orhuntas/EE464HW-SontAS/README.md

# EE464HW-SontAS
EE464 Hardware Project Repository for Şönt A.Ş.
