orhuntas/EE464HW-SontAS/simulation report/title.tex

\begin{titlepage}
\newcommand{\HRule}{\rule{\linewidth}{0.5mm}}
\setlength{\topmargin}{0 in}
\begin{center}

\begin{figure}[!h]
\centering
\includegraphics [width=0.3\textwidth]{eelogo.png}
\end{figure}

\vspace{10mm}
\Huge{MIDDLE EAST TECHNICAL UNIVERSITY}\\
\vspace{5mm}
{\LARGE ELECTRICAL \& ELECTRONICS ENGINEERING}\\
\vspace{4mm}
\LARGE{Şönt A.Ş.}\\

\HRule\\[0.4cm]
\textsc{\Large{EE464 - STATIC POWER CONVERSION II}}\\
\textsc{\Large{Hardware Project - Flyback Converter\\}}
\textsc{\Large{Simulation Report\\}}
\HRule\\[0.4cm]

\vspace{3mm}

\end{center}
\begin{minipage}{1\textwidth}
		\begin{flushleft}
			\large
			Orhun  \textsc{Taşoğlu - 2094506}\\
			Fahri \textsc{Türedi - 2167435}\\
			Nurettin \textsc{Çavuş - 2094878}
			
		\end{flushleft}
	\end{minipage}

\vspace{10mm}
\begin{center}
\large{23.03.2020}
\end{center}
\end{titlepage}
