orhuntas/EE464HW-SontAS/Final Report/tex/main.tex

\documentclass[12]{article}

\usepackage{gensymb}

\usepackage{float}
\usepackage{float}
\usepackage{booktabs}
\usepackage{multirow}
\usepackage{subcaption}

\usepackage{amsmath}

\usepackage[utf8]{inputenc}
\usepackage[T1]{fontenc}
\setlength{\oddsidemargin}{0.25 in}
\setlength{\evensidemargin}{-0.25 in}
\setlength{\topmargin}{-0.6 in}
\setlength{\textwidth}{6.5 in}
\setlength{\textheight}{8.5 in}
\setlength{\headsep}{0.75 in}
\setlength{\parindent}{0 in}
\setlength{\parskip}{0.1 in}
\usepackage[a4paper,margin=3 cm,footskip=.5cm]{geometry}
\usepackage{textcomp}
\usepackage[table,xcdraw]{xcolor}
\usepackage{hyperref}

\hypersetup{
    colorlinks,
    citecolor=black,
    filecolor=black,
    linkcolor=blue,
    urlcolor=blue
}
\usepackage{graphicx}
\usepackage[inkscapeformat=pdf,inkscapelatex=false]{svg}
%https://www.overleaf.com/project/5ecb94c99100ce000119a4ac
\graphicspath{ {./figs/} }

\begin{document}

\input{title.tex}
\tableofcontents
\newpage
\input{Introduction}
\input{Flyback_Design}
\input{Magnetic_Design}
\input{Simulations}
\input{Component_Selection}
\input{Efficiency_Analysis}
\input{Thermal_Analysis}
\input{Closed_Loop_Control}
\input{PCB_Design}
\input{Conclusion}
\input{Acknowledgement}
\input{References}
\end{document}
