orhuntas/EE464HW-SontAS/Final Report/tex/References.tex

\section{References}
 $[1]$ Hart, D. W. (2011). Power electronics. New York: McGraw-Hill\\
 $[2]$ Erickson, R. W. (2020). Fundamentals of Power Electronics. Boston: SPRINGER NATURE\\
 $[3]$ Hurley, W.G. , Wölfle, W.H. (2013). Transformers and Inductors for Power Electronics. Noida:John Wiley & Sons Ltd. \\
 $[4]$ UCC28740 datasheet. (n.d.). Retrieved June 24, 2020, from https://www.ti.com/document-viewer/UCC28740/datasheet/features-slusb417558\\
 $[5]$ Seri Lee. (2015) How to Select Heat Sink from https://www.mouser.com/catalog/specsheets/ AavidHowtoSelectaHeatSink.pdf\\
