orhuntas/EE464HW-SontAS/Final Report/PCB/pcbcomplete/flyback.html

# C:\Users\Fahri\Desktop\flyback\flyback.sch

02.06.2020 00:22:01

Eeschema (5.0.0)

Component Count:32

Ref | Qnty | Value | Part | Datasheet | Description | Vendor
CFB1, Ccs1, Cext1, Css431, Cvdd1, Cz1 | 6 | C | Device:C | ~ | Unpolarized capacitor
Cout1, Cout2 | 2 | CP1 | Device:CP1 | ~ | Polarised capacitor
D1 | 1 | D | Device:D | ~ | Diode
Daux1 | 1 | DIODE | pspice:DIODE
Dclamp1 | 1 | D_Zener | Device:D_Zener | ~ | Zener Diode
Dout1 | 1 | D_Schottky | Device:D_Schottky | ~ | Schottky diode
J1, J2 | 2 | Screw_Terminal_01x02 | Connector:Screw_Terminal_01x02 | ~ | Generic screw terminal, single row, 01x02, script generated (kicad-library-utils/schlib/autogen/connector/)
Lout1 | 1 | L | Device:L | ~ | Inductor
M1 | 1 | MNMOS | pspice:MNMOS | | N-channel MOSFET
R9, RFB1, RFB2, RFB3, RFB4, RLC1, RTL1, RVS1, RVS2, RinJ1 | 10 | R | Device:R | ~ | Resistor
RCS1, Rvdd1 | 2 | R | Device:R | ~ | Resistor
T1 | 1 | Transformer_1P_2S | Device:Transformer_1P_2S | ~ | Transformer, single primary, dual secondary
TL431 | 1 | TL431D | Reference_Voltage:TL431D | http://www.ti.com/lit/ds/symlink/tl431.pdf | Shunt Regulator, SO-8
U1 | 1 | SFH617A-1 | Isolator:SFH617A-1 | http://www.vishay.com/docs/83740/sfh617a.pdf | Optocoupler, Phototransistor Output, 5300 VRMS, VCEO 70V, CTR% 40-80, -55 to +110 degree Celcius, UL, BSI, FIMKO, cUL, THT PDIP-4
U2 | 1 | NCP1207B | Regulator_Controller:NCP1207B | http://www.onsemi.com/pub/Collateral/NCP1207B.PDF | PWM Current-Mode Controller for Free Running Quasi-Resonant Operation, AC-DC, 4.5us min Toff, SOIC-7
