orhuntas/EE464HW-SontAS/EE464_Hardware_Project.pdf

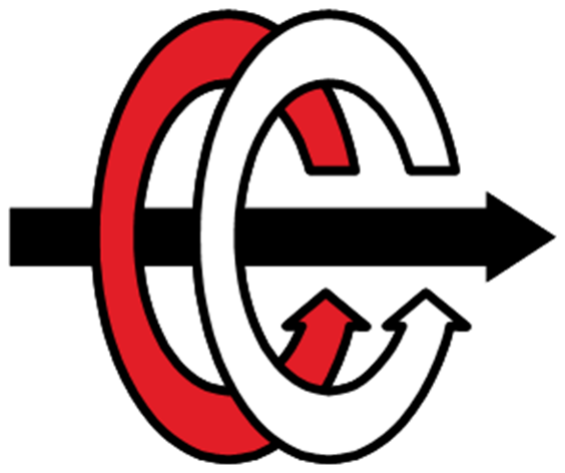
[picture p92: figure]

# MIDDLE EAST TECHNICAL UNIVERSITY

## ELECTRICAL & ELECTRONICS ENGINEERING

Şönt A.Ş.

EE464 - STATIC POWER CONVERSION II

Hardware Project - Flyback Converter

Simulation Report

Orhun Taşoğlu - 2094506

Fahri Türedi - 2167435
Nurettin Çavuş - 2094878

23.03.2020

## Contents

1 Introduction | 2
2 Topology Selection | 2
3 Flyback Converter Design | 4
4 Simulation Results | 8
5 Component Selection | 22
6 Conclusion | 28
7 References | 28

## 1 Introduction

One of the most commonly used circuit to perform DC-DC conversions are Switching Mode Power Supplies (SMPS). To provide a safer output and to comply with international standards isolation of output from the input side is required, especially in grid-connected applications. There are two main topologies of the dc-dc converters with galvanic isolation which means there is no electrical contact between two sides are the Flyback Converters and Forward Converters. These topologies provide isolation thanks to the isolation transformer placed between the two sides. The isolation transformer also provides larger bandwidth or operation range on the voltage transfer capabilities by adjusting the primary to secondary turns ratio. Hence, these topologies reduce the weight of the duty ratio on the voltage transfer capability by having the turn ratio of the transformer to make the most of the work.

In this report, fundamental points of our design, parameter calculations. simulation results and key components for building the Flyback Converter topology are explained. First of all, the reasoning behind the topology selection is presented. Then, the design methodology of the Flyback Converter is given with the design goals and parameter calculations in the following part. The magnetic design of the transformer is also be explained in detail. Depending on the design selections and computed parameters, the simulation results of the constructed topology is presented in the Simulation Results part of the report. Finally, the component selections for the semiconductor devices are included according to the maximum current and voltage stresses over them, which are computed by the analytical calculations and observed during the simulations. The magnetic core selection for the transformer is can be found in that part of the report too. Furthermore, the appropriate cable selection both for the primary and secondary sides of the transformer is done considering the effects like the skin effect and the proximity effect together with the maximum currents flowing through the transformer windings.

## 2 Topology Selection

Selected Topology: FLY#1

We, as Şönt A.Ş., selected the Flyback Converter topology FLY#1 over Flyback Converter options and Forward Converter topology for a number of reasons. First of all, it includes less number of components compared to the Forward Converter topology. Hence, the cost is reduced compared to the Forward Converter topology. Another reason is that it does not require an output filter inductor, which makes the magnetic design phase easier compared to the Forward Converter topology. As a result, there is no need for a second core selection and extra magnetic design for an output filter inductor. In terms of these aspects, the Flyback Converter topology is the simplest topology among the other options.

Furthermore, the voltage gain control of the Flyback Converter topology in DCM operation is easier than that in the Forward Converter topology. As a result, the current mode control and the voltage mode control of the Flyback Converters can be made in DCM operation, which also helps to reduce the current stress over the MOSFET and the diode during switching since the switching is done when the current is equal to zero. Zero current switching also eliminates the reverse recovery losses over the output rectifier diode. Furthermore, the DCM operation allows switching the MOSFET when the voltage across the drain to source terminals of the MOSFET is approximately equal to the input voltage. This greatly reduces the switching losses of the converter since the switching losses are proportional to the square of the drain to source voltage of the MOSFET.

The availability of DCM operation also enables the valley switching operation, which further decreases the switching losses by making it possible to switch the MOSFET while the drain to source voltage is at its minimum below the input voltage. This operation requires frequency modulation (FM) controlled by a controller. Since we found the UCC28740 to be widely available, inexpensive and capable of completing the tasks given in the project, we decided to build our Flyback Converter around it. The EMI effects are also reduced with the valley switching operation. All in all, these operation modes make the Flyback Converter topology obtain a higher efficiency than Forward Converter topology. One another advantage of the availability of DCM operation is that it helps to reduce the required inductance value for the transformer, which helps to reduce the transformer size and weight. If we evaluate the two topologies in terms of voltage stress over the switching MOSFET, the voltage stress over the switching MOSFET in Flyback Converter topology is less than that in the Forward Converter topology. These points and considerations conclude our selection of Flyback Converter topology over Forward Converter topology.

Now, the final topology selection among the three possible Flyback Converter topology options FLY#1, FLY#2 and FLY#3 will be explained.

If we compare the Flyback Converter topology options FLY#1, FLY#2 and FLY#3 in itself, we did not want to work with AC input voltage since it would require an extra input full bridge rectifier together with an very large filter capacitor at the rectifier output. This eliminated the option FLY#3 for us. Then, between FLY#1 and FLY#2, we selected the FLY#1 option since its output voltage is higher than that of FLY#2 option. This makes the average output current in FLY#1 less than that in the FLY#2, which helps to increase the efficiency in the FLY#1 option compared to FLY#2 option. Also, the current ripples and maximum current ratings will be smaller in FLY#1 due to smaller average output current. In addition, the higher output voltage for the same output voltage ripple limit of 4% helps to choose the output filter capacitor smaller in FLY#1 option, which reduces the filter size. For these reasons, we selected the FLY#1 option.

## 3 Flyback Converter Design

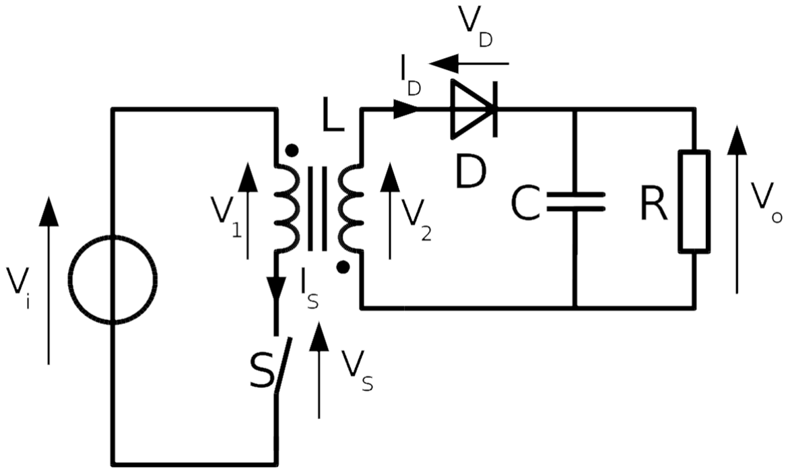
[picture p93: figure]

Figure 1: Ideal Flyback Converter

An ideal flyback converter topology is given in Figure 1. It is a galvanically isolated DC-DC converter with a special feature. That special feature is using the magnetizing inductance of the transformer as an energy storage device, instead of a separate circuit component, which helps reduce the cost, volume and mass of the converter. For our hardware project, we will build a Flyback Converter with extra features to establish the flexibility and performance required to achieve the main requirements and collect bonus points from the Hardware Project.

Our circuit’s main controller is UCC28740 by Texas Instruments. It can achieve both current mode and voltage mode control by taking feedback from input and output sides. For UCC28740 to perform properly, the rest of the circuit should be set to achieve DCM operation at all times. UCC28740 can achieve valley switching, which means it will try to switch the MOSFET at the lowest possible voltage than the primary voltage to increase the efficiency. Those voltage levels are called valley points which are bottoms of the voltage swing at the primary, as seen in Figure 2. The lower voltage level is seen because of the ringing when primary current reaches zero. This kind of Flyback Converter called Quasi-Resonant Flyback Converter.

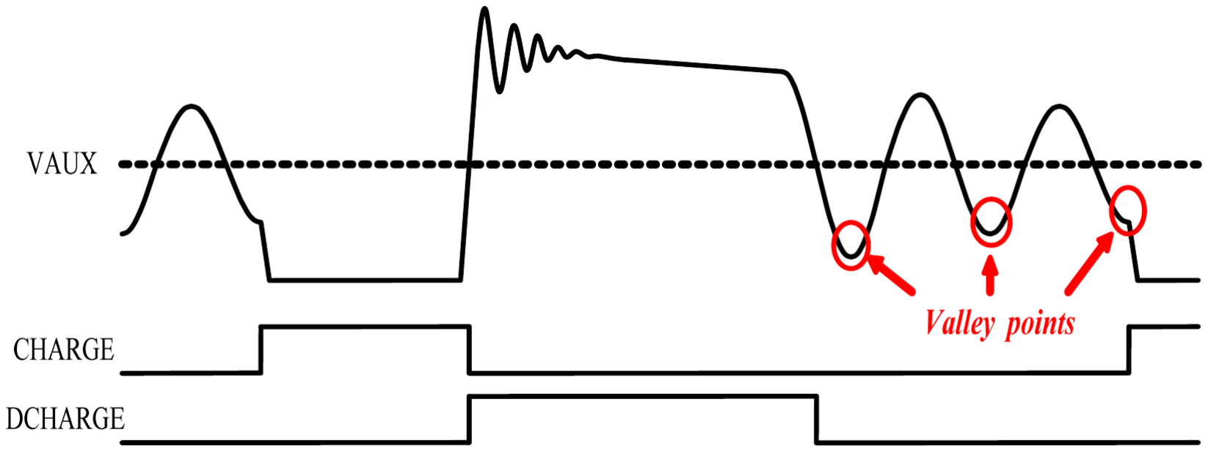
[picture p94: figure]

Figure 2: Vallet Points of a Quasi-Resonant Flyback Converter

To be able to handle synchronous switching, UCC24636 by Texas Instruments will be used at the secondary side. The reference design for the mentioned ICs is given in Figure 3.

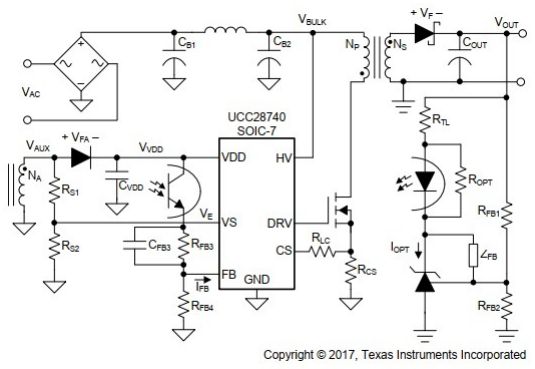
[picture p95: figure]

Figure 3: Reference Flyback Converter Design with UCC28740

### 3.1 Design Goals

Complying with the specifications given in the project description, Table 1 is prepared as a summary. Our design must accomplish the given performance measures. In addition to these, the circuit must employ a closed-loop control. Furthermore, to maximize the functionality and gain bonus points we aimed to go for each positive bonus parts described.

Table 1: Project Specifications
Paremeter | Min | Typical | Max | Unit
INPUT
Vin | Input Voltage | 24 | 36 | 48 | VDC
OUTPUT
Vout | Output Voltage | 14.4 | 15 | 15.6 | VDC
Iout | Output Current | - | 3.75 | - | A
Pout | Output Power | | 60 | | W
| Line Regulation | | | 2 | %
Load Regulation | 2 | % height

### 3.2 Parameter Calculations

Duty Cycle, Turns Ratio, Primary Inductance, Peak Primary Current

Since the target maximum switching frequency imposed by the limitations of our controllers, it is designated as 45 kHz. DMAGCC is defined as ‘The secondary diode conduction duty-cycle limit in CC mode, 0.425. which is a device parameter to make sure the transformer is demagnetized and DCM is established. Assuming 500 kHz as the DCM resonance frequency, the times it takes to reach the first valley of VDS, tR should be substracted so that valley switching can be made possible too. To find the maximum duty cycle for constant CCM operation,

DMAX = 1 − DMAGCC − fMAX ×

tR
2

DMAX = 1 − 0.425 − 45kHz ×

2µs
2

= 0.53

Since DMAX is known, maximum primary to secondary turns ratio can be determined with the following equation:

NP S,MAX =

DMAXVDC,min

DMAGCC (VO + vF

) = 0.53 × 24 0.425 ∗ (15.7) = 1.906

Since the voltage at the current sense feedback pin of the controller, VC ST is limited, first we need to determine de RCS to limit the the primary peak current,IP P .

RCS =

VCCRNP S
2IO

√
ηtransformer = 74.3mΩ

IP P,MAX =

VCST ,MAX

RCS

=

0.773
0.0746

= 10.4A

Where VCCR is a device parameter called constant-current regulation factor and is equal to 330mV. To compansate the voltage ripples on the input capactiors, a factor of 0.6 is used.

To ensure enough energy can be stored in the transformer and DCM operation is established, primary inductance should be specified properly It should be noted that the transformer will cause losses so they need to taken into consideration too. Assuming % efficiency, magnetizing inductance is calculated.

LP =

2(VO + VF )IO

ηtransformerI

2
P P,MAXfMAX

=

2 × 15.7 × 4
0.9 × 10.4

2 × fMAX

= 28.67µH

Lastly, since we will need an auxiliary winding to power the controller to sense the primary voltage and utilize low voltage lockout, turns ratio of it should be calculated too. Assuming the lockout voltage to be 15V, and auxiliary diode voltage drop to be 0.5 Volts. Lastly, the upper limit for auxiliary to secondary turns ratio is calculated according to the lowest supply voltage of the controller, VDD,of f

NAS,MAX =

VDD,min + VF A
VO + VF

=

7.75 + 0.5
15 + 0.7

= 0.525

NP A,MAX =

1.9
0.525

= 3.62

### 3.3 Transformer Parameter Verification

To be able to choose our components properly, the stresses on them should be calculated to make an informed decision. Turns ratio of the transformer affects the peak voltages on the rectifiers. Also, demagnetization and MOSFET on times are should be verified so that the values are in the internal timing limits of our controller. Reverse voltages on primary and secondary rectifiers are,

VReverse,secondary =

VIN,MAX√
2
NP S

+ VO,MAX = 77.8V

VReverse,primary =

VIN,MAX
NP A

+ VV DD = 23.25V

For MOSFET VDS peak voltage calculation;

VDS,peak = VIN,MAX + (VO + VF )NP S = 97V

To find our circuits ON time and Demagnetization times,

tON,min =

LP

VIN,MAX

Iprimary,MAX
4

= 1.51µs

tDmag.M in =

tON,minVIN,MAX
NP S(VO + VF )

= 2.9µs

The minimum required ON time for our controllers is indicated as 280 nS and minimum Demagnetizing time is specified as 2.4 µS. Both criteria are satisfied and our circuit can operate in nominal conditions.

### 3.4 Magnetic Design

Firstly, the shape of the transformer core is selected as an E-core. Since E-cores can be winded better than toroid cores. To have enough turn numbers on both primary and secondary side, KOOL MU 2510 E CORE(00K2510E090) is selected. Cross-section area of the core is important for turn numbers and core area of the KOOL MU 2510 E CORE is small enough to have 10 turns on the primary side. Parameters of the chosen E-core is given below;

Ae = 35mm²
(CrossSectionArea) | (1)
le = 48.5mm(P athLength) | (2)
µc = 90(RelativeP ermeability) | (3)
Bc = 1T(SaturationFluxDensity) | (4)
W eight = 5.9gandVe = 1870mm³
(V olume) | (5)

According to chosen core secondary turn numbers was calculated.

NS =

LP × Ipeak
n × Bm × Ae

(6)

NS =

28.67 × 10⁻⁶ × 10.8
1.9 × 1 × 35 × 10⁻⁶
= 5.2turns | (7)

Ratio of the primary turn numbers to secondary turn numbers is calculated, so primary turn number is given below;

NP = n × NS = 1.9 × 5.2 = 10turns | (8)

In this flyback converter design, UCC28740 analog controller is chosen to control the output voltage and current. To supply VCC(7.75V) to UCC28740 analog controller, there is required auxiliary winding come from the transformer. The turn number of the auxiliary winding is calculated below;

NV CC =

VCC
VO + VF

× NS =

7.75
12 + 0.7
× NS = 3turns | (9)

There is a core gap on the E-core. Core gap is crucial because magnetic flux intensity can be controlled by the core gap. If there is smaller gap than required, the core can be saturated and transformer could not work properly. Also the other components of the flyback converter can be damaged due to overload. Required core gap is calculated to have optimum magnetic design. Calculation of the core gap is given below;

gap =

µ0 × NP

2 × Ae
LP

−

Ie
µc

=

1.256 × 10⁻⁶ × 10² × 35 × 10⁻⁶ 28.67 × 10⁻⁶

−

48.5 × 10⁻³
90

= 1.35 × 10⁻³m (10)

To check the calculated values given equations is done. Magnetic flux intensity is crucial, since if it is higher than the saturation level of the core, saturation level of the chosen core is 1 Tesla.

B =

µ0 × NP × IP

Ie
µc

+ gap

=

1.256 × 10⁻⁶ × 10 × 10.8

48.5×10⁻³
90 | + 3.85 × 10⁻³
= 0.95 | (11)

Vr =

NP
NS
× (VO + VF ) = 24.13V | (12)

0.95 Tesla is lower than saturation level of the core so it is acceptable. Also duty ratio must be lower than
0.53. To check duty ratio of the design, D is calculated below;

D =

Vr
Vr + V dc(min)
= 0.5 | (13)

## 4 Simulation Results

The designed converter topology is simulated in Simulink to verify desired functioning of the circuit.

For simplicity, the controller topology and feedback mechanisms are not included in the circuit schematic of the simulation model. Furthermore, the semiconductor devices and filter capacitors and inductors are taken ideal without voltage drops and ESR values.

In order to verify the operation of the circuit, we simulated the converter at its two extreme boundary points for input voltage of Vin = 24 V and Vin = 48 V .

The Simulink simulation model of the Flyback Converter circuit is given in Figure 4.

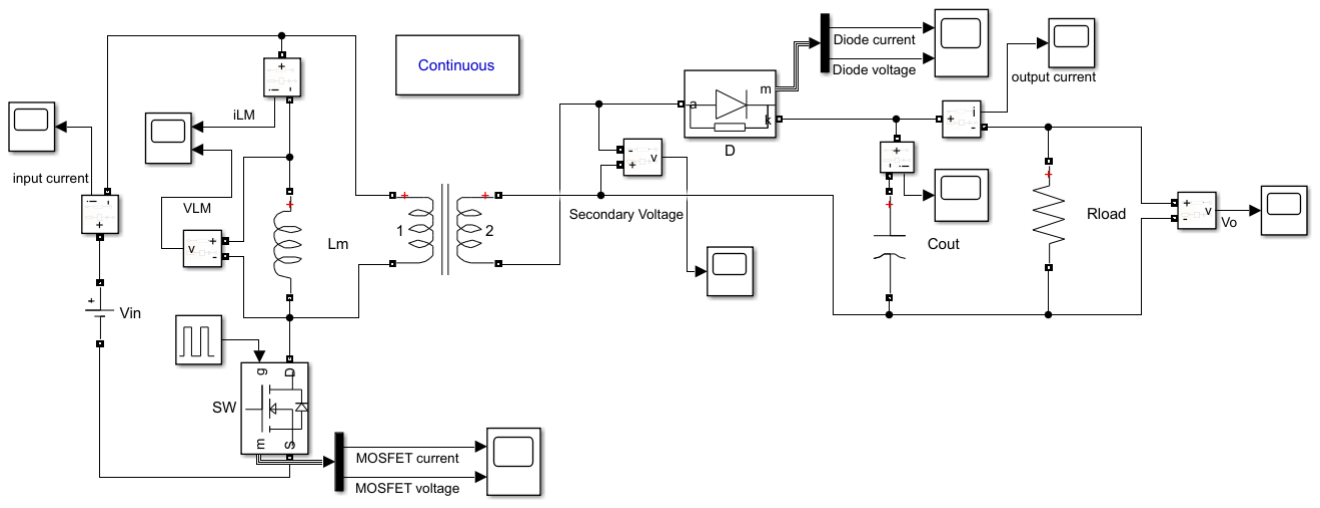
[picture p96: figure]

Figure 4: Simulink Circuit Schematic of the Flyback Converter

### 4.1 Simulation Results for Vin = 24 V

The simulation results of the converter circuit for input voltage of Vin = 24 V are given below.

The duty cycle of the MOSFET is determined as D = 52.5% (0.525) for this operation in order to keep the average output voltage at 15 V.

The duty cycle of the MOSFET is determined by some trial and errors since the converter circuit is operating in DCM. In DCM operation, the standard voltage gain equation can no more be utilized to determine the duty ratio.

The input current waveform of the converter circuit is given in Figure 5.

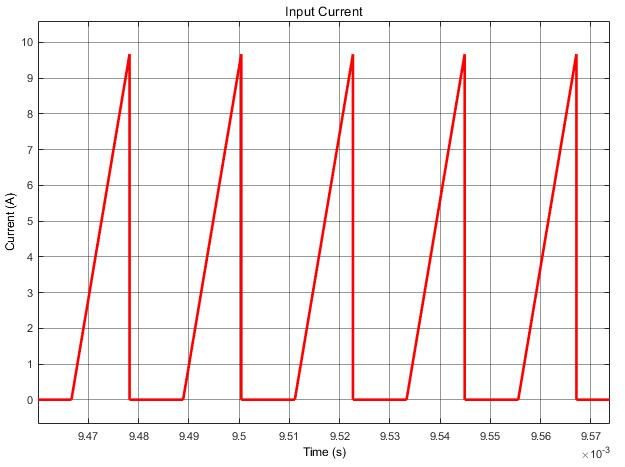
[picture p97: figure]

Figure 5: Input Current Waveform of the Flyback Converter for Vin = 24 V

The input current ripple is high as can be seen from Figure 5 since the switch is positioned in series to the input side. The maximum current drawn from the input source and the peak to peak input current ripple is equal to 9.681 A. The high input current ripple might cause EMI effects by affecting the operation of the analog controller and gate driver circuit of the switch.

The MOSFET current and voltage waveforms of the converter circuit are given in Figure 6.

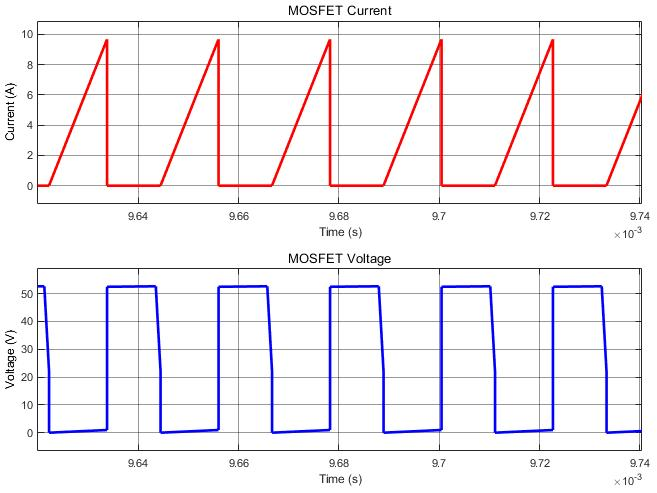
[picture p98: figure]

Figure 6: MOSFET Current and Voltage Waveforms of the Flyback Converter for Vin = 24 V

The maximum current through the MOSFET during its on period is observed from Figure 6 to be 9.681 A. The maximum voltage across the switch during its off period is also observed to be 52.63 V.

The voltage and current waveforms of the magnetizing inductor of the transformer of the converter circuit are given in Figure 7.

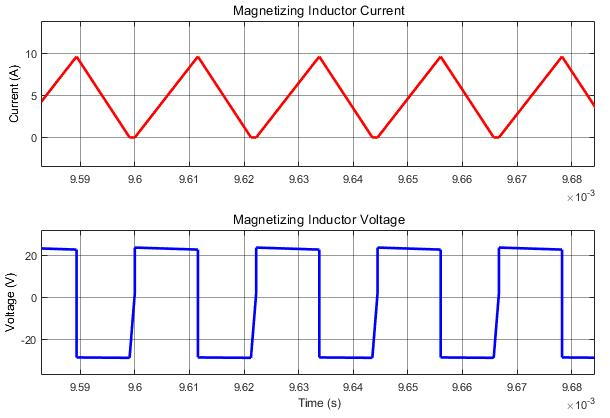
[picture p99: figure]

Figure 7: Magnetizing Inductor Voltage and Current Waveforms of the Flyback Converter for Vin = 24 V

The DCM operation of the converter circuit can also be observed from the magnetizing inductor current waveform given in Figure 7. It is seen from the Figure 7 that the inductor current reaches to zero and stays at zero for a finite duration until the next switching cycle.

The maximum magnetizing inductor current is observed to be equal to 9.669 A from the simulations.

The magnetizing inductor voltage switches between 24 V and -28.63 V during the switching operation.

The diode voltage and current waveforms of the converter circuit are given in Figure 8.

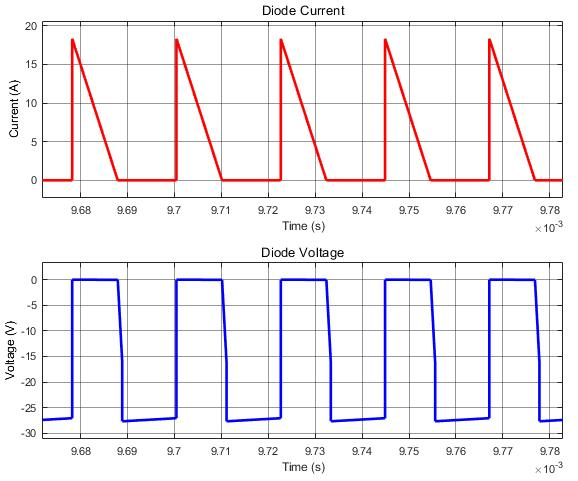
[picture p100: figure]

Figure 8: Diode Voltage and Current Waveforms of the Flyback Converter for Vin = 24 V

The voltage waveform on the secondary side of the transformer of the converter circuit is given in Figure ??.

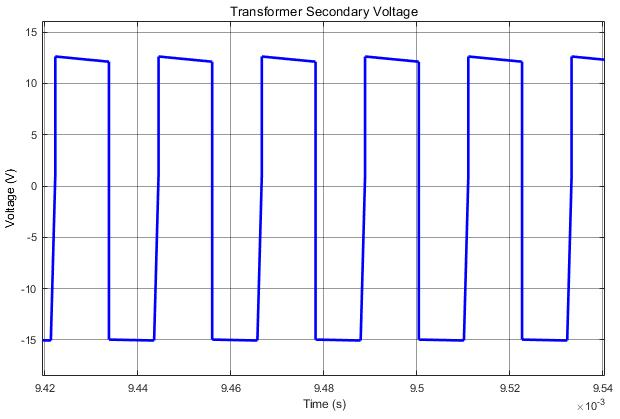
[picture p101: figure]

Figure 9: Secondary Voltage Waveform of the Transformer of the Flyback Converter for Vin = 24 V

The secondary side voltage of the transformer switches between 12.63 V and -15 V during the switching operation.

The output current waveform of the converter circuit is given in Figure 10.

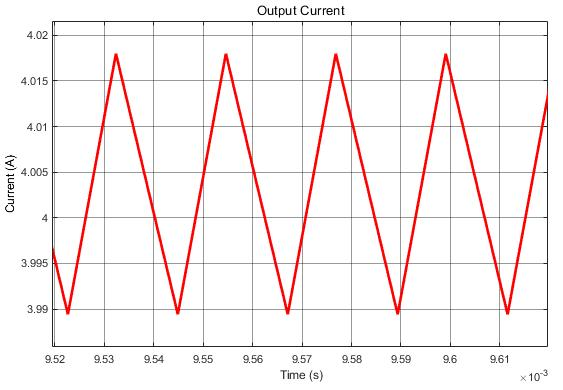
[picture p102: figure]

Figure 10: Output Current Waveform of the Flyback Converter for Vin = 24 V

The average output current is approximately obtained as 4 A.

The output voltage waveform of the converter circuit is given in Figure 11.

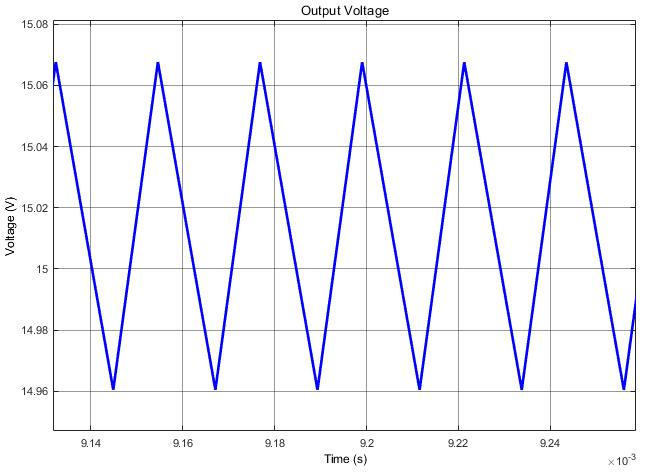
[picture p103: figure]

Figure 11: Output Voltage Waveform of the Flyback Converter for Vin = 24 V

The average output voltage is obtained as 15 V as can be seen from Figure 11. The peak to peak output voltage ripple is approximately equal to 0.116 V, which is less than the desired peak to peak output voltage ripple limit (4%) of 0.6 V.

### 4.2 Simulation Results for Vin = 48 V

The simulation results of the converter circuit for input voltage of Vin = 48 V are given below.

The duty cycle of the MOSFET is determined as D = 26% (0.26) for this operation in order to keep the average output voltage at 15 V.

As a result, the converter circuit is expected to be operated between 26% and 52.5% duty ratios between the two boundary input voltages of 24 V and 48 V.

The input current waveform of the converter circuit is given in Figure 12.

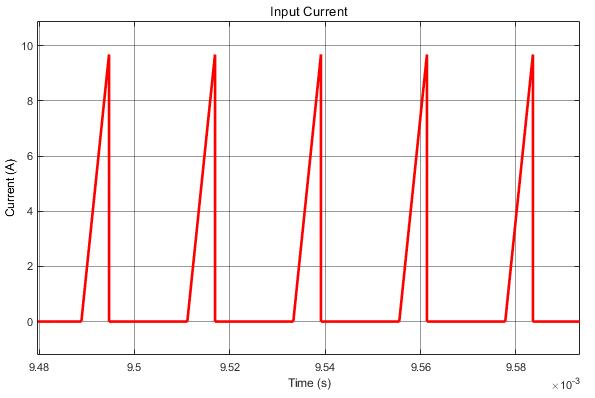
[picture p104: figure]

Figure 12: Input Current Waveform of the Flyback Converter for Vin = 48 V

Similar to the previous condition, the input current ripple is high as can be seen from Figure 12 since the switch is positioned in series to the input side. The maximum current drawn from the input source and the peak to peak input current ripple is equal to 9.690 A. The high input current ripple might cause EMI effects by affecting the operation of the analog controller and gate driver circuit of the switch.

The MOSFET current and voltage waveforms of the converter circuit are given in Figure 13.

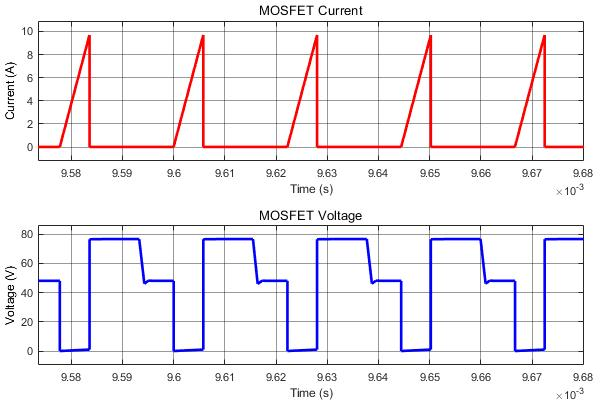
[picture p105: figure]

Figure 13: MOSFET Current and Voltage Waveforms of the Flyback Converter for Vin = 48 V

The maximum current through the MOSFET during its on period is observed from Figure 13 to be 9.690
A. The maximum voltage across the switch during its off period is also observed to be 76.63 V.

It is also possible to clearly observe the DCM operation of the converter circuit from the MOSFET voltage waveform given in Figure 13. During the off period of the switch, the voltage across the MOSFET is equal to 76.63 V until the magnetizing inductor current becomes zero. Then, until the next switching cycle (until the MOSFET becomes on again), the MOSFET voltage drops down to the input voltage (VMOSF ET = 48 V ) and stays at this level.

The voltage and current waveforms of the magnetizing inductor of the transformer of the converter circuit are given in Figure 14.

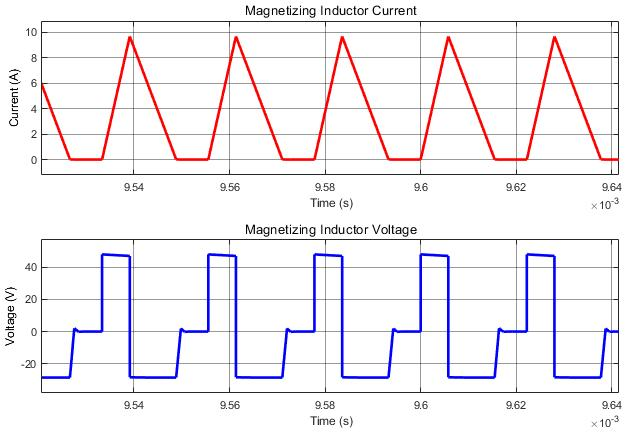
[picture p106: figure]

Figure 14: Magnetizing Inductor Voltage and Current Waveforms of the Flyback Converter for Vin = 48 V

Again, it is also possible to observe the DCM operation from the magnetizing inductor current and voltage waveforms given in Figure 14.

The maximum magnetizing inductor current for this operation is observed to be equal to 9.664 A.

The magnetizing inductor current discharges through the transformer and reaches to zero during the off period of the switch, and stays zero until the next switching cycle (until the MOSFET becomes on again). The magnetizing inductor voltage during that process changes from -28.63 V to 0 V when the inductor current becomes zero. During the on period of the switch, the magnetizing inductor voltage is equal to the input voltage (Vinductor = 48 V ), and the magnetizing inductor charges linearly.

The diode voltage and current waveforms of the converter circuit are given in Figure 15.

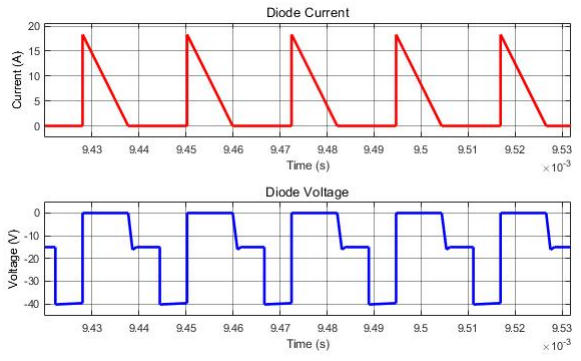
[picture p107: figure]

Figure 15: Diode Voltage and Current Waveforms of the Flyback Converter for Vin = 48 V

The DCM operation can also be clearly observed from the diode voltage waveform given in Figure 15. During the off period of the switch, the diode stays on until the magnetizing inductor current becomes zero. Then, the diode becomes off, and stays off until the next off period of the switch. The reverse voltage across the diode during its off period changes from -15 V to -40.263 V due to this DCM operation.

The voltage waveform on the secondary side of the transformer of the converter circuit is given in Figure ??.

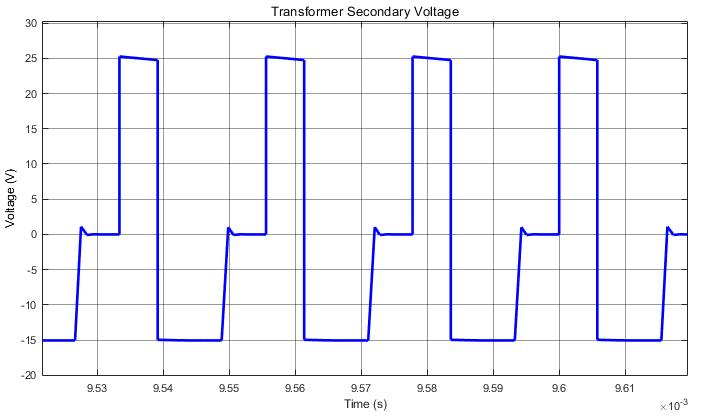
[picture p108: figure]

Figure 16: Secondary Voltage Waveform of the Transformer of the Flyback Converter for Vin = 48 V

Similarly, the secondary side voltage of the transformer also exhibits some DCM behavior. During the off period of the switch, the secondary voltage is equal to the negative of the output voltage (Vsec = −15 V ) until the magnetizing inductor current becomes zero. When the magnetizing inductor current becomes zero, the diode at the output side switches off and the secondary side voltage becomes zero.

During the on period of the switch, the magnetizing inductor charges from input. Hence, the voltage across the primary side of the transformer is equal to the input voltage (Vpri = 48 V ). As a result, the secondary side voltage becomes 25.263 V during that period due to the turn ratio between the primary and the secondary.

The output current waveform of the converter circuit is given in Figure 17.

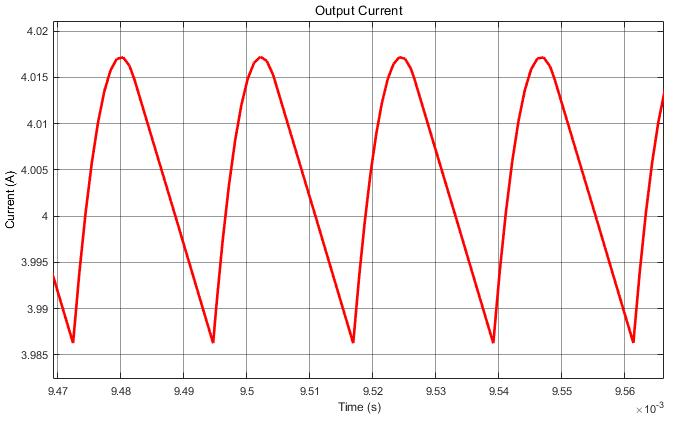
[picture p109: figure]

Figure 17: Output Current Waveform of the Flyback Converter for Vin = 48 V

As seen from Figure 17 output current waveform is between 3.987 and 4.017. This current ripple is good enough for Flyback Converter. There is only resistive load, so output ripple current must be smaller than 0.15 A. In this simulation results, output current ripple is 0.03 A which is less than 0.15 Ampere.

The output voltage waveform of the converter circuit is given in Figure 18.

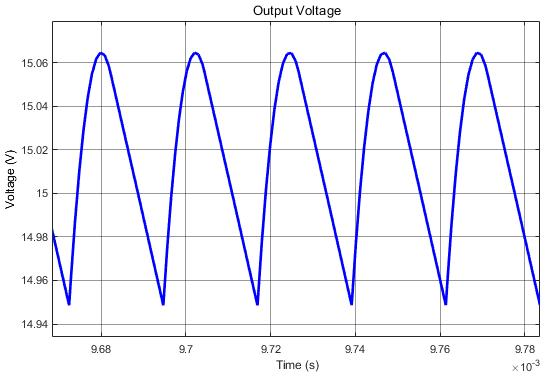
[picture p110: figure]

Figure 18: Output Voltage Waveform of the Flyback Converter for Vin = 48 V

As seen from Figure 18. output voltage waveform is between 15.06 and 14.96 V. Expected output voltage of e design is 15 V and output voltage ripple limit is 0.6 V. 15.06−14.96 = 0.1v is below the design specification limits. This output voltage ripple depends on output capacitor. 470 µF capacitor was used in simulations. Average output voltage is 15 V as expected. There is resistive load on the flyback converter thats why the shape of the output voltage is similar to the output current. Actually output voltage waveform is 3.75 times output current waveform. Output voltage waveform for 48 V input should be similar with output voltage waveform but there is differences due to different time intervals.

## 5 Component Selection

### 5.1 Transformer Selection

According to design calculations and simulation results, Peak current of the transformer 10.8 Ampere, turn ratio of the transformer is 1.9:1, primary turn number of transformer 10, secondary turn number 5, Transformer primary side voltage is between 24-48 V which is input voltage range. To obtain required turn numbers, the cross-section area of the core must be smaller than 40 mm² and core saturation density of the available cores B=1 Tesla. According to the required cross-section area range, KOOL MU 2510 E core was chosen. Cross-section area of the chosen core is 38.5 mm²
. Permeability of the core is given in Figure 19.

Permeability of the KOOL MU 2510 E Core is 90µ.

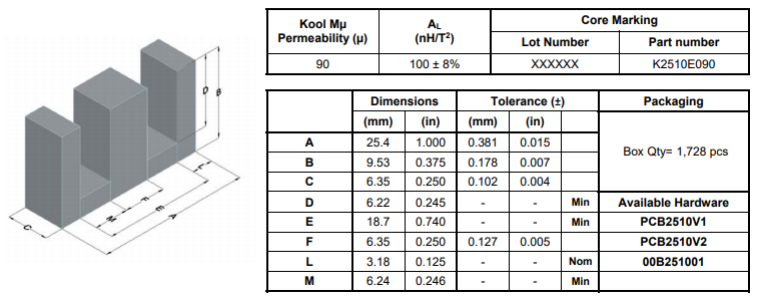
[picture p111: figure]

Figure 19: Detailed dimensions of the E core and relative permeability of core

The cross-section area is important to decide turn numbers and the gap between cores. Information about cross-section area and path length is given Figure 20. As seen in (13), the gap is directly affected by path length and relative permeability, so both path length and relative permeability are also crucial for design.

gap =

µ0 × N²
P × Ae
LP

−

le
µc

(14)

Magnetic flux density of the core can be calculated by given formula;

B =

µ0 × NP × Ae

le
µc

+ gap

(15)

As seen from formula (14), magnetic flux density depends on the cross-sectional area, path length and relative permeability of the core. Cross-sectional area and relative permeability is limited since core can be saturated. Magnetic flux density is inversely proportional with gap and path length. As seen from Figure 21, saturation flux density of the KOOL MU magnetic cores is 1 Tesla. Core shape, cross-section area and path length are chosen according to the saturation flux density of the KOOL MU magnetic core.

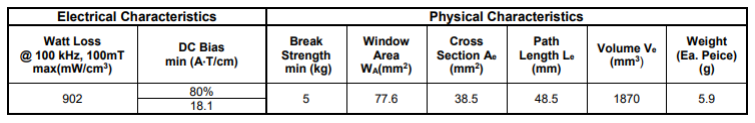
[picture p112: figure]

Figure 20: Cross section area and Path Length of core

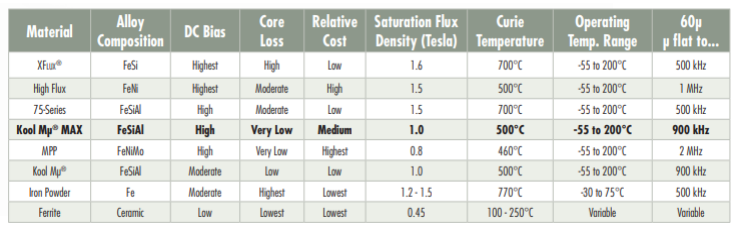
[picture p113: figure]

Figure 21: Saturation Flux Densities of various magnetic cores

### 5.2 Analog Controllers Components

Two analog controllers are used in the project for a highly flexible, efficient and feature-packed converter. The main controller is UCC28740 Constant-Voltage Constant-Current Flyback Controller Using Optocoupled Feedback by Texas Instruments. It will be powered by an auxiliary winding wound to the transformer. It is designated to be always used in DCM operation. It can take feedback from both primary and secondary sides and can keep output voltage constant and performs well in load and line regulation aspects. It has an embedded MOSFET driver to save space lower the component count. Furthermore, its internal algorithm also provides soft-switching to lower the initial stresses on the components.

To control synchronous switching in the secondary, UCC24636 Synchronous rectifier controller With Ultra-Low Standby current is used. It helps to replace the secondary side diode with a MOSFET to mimic its operation. As a result, the loss on diode is eliminated. Since losses on the MOSFET will be significantly lower, overall efficiency is improved. In Figure 22 a reference design which includes both controllers is given.

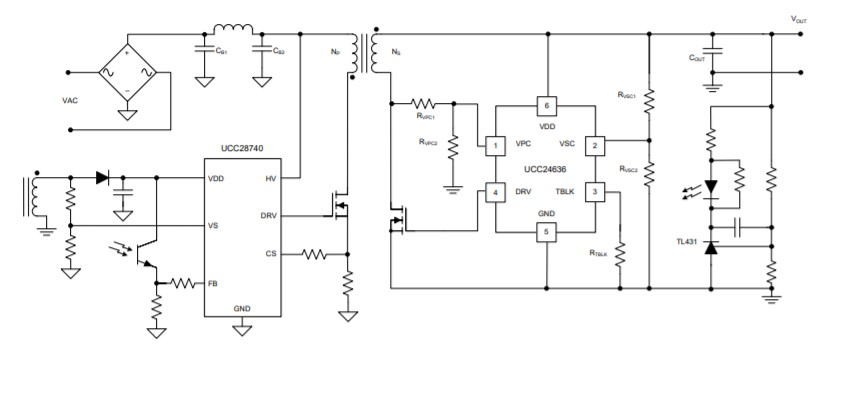
[picture p114: figure]

Figure 22: Flyback Controller Reference Design with UCC28749 and UCC24636

### 5.3 Cable Selection

δ= Skin Depth
ρ= Resistivity of Material
µr= Relative Permeability of Cable µ0= Permeability Constant = 4π × 10⁻⁷ f= switching frequency = 45 kHz

δ =

r ρ
π × f × µr × µ0

(16)

Copper cable will be used in this flyback converter.

δ =

7.5
√
f
cm | (17)

δ =

7.5
45000

= 1.67 × 10⁻⁴
cm | (18)

At 45 kHz switching frequency, skin depth of copper cable is 1.67×10⁻⁴
cm. There is maximum 3 Ampere average current on transformer cable, so diameter of the cable must carry 3 ampere average current. To carry 3 ampere, AWG of the cable must be lower than 25 AWG. To avoid unexpected damages to our circuit, 20 AWG copper cable will be used.

### 5.4 MOSFET Selection

For the MOSFET selection, we need to consider the maximum voltage and current stresses over the MOSFET.

The maximum voltage stress over the MOSFET is obtained analytically by the following relation.

Vsw,peak = Vin,max +

NP
NS

Vout

where Vin,max = 48 V , Vout = 15 V and NP
NS

= 1.9.

Then, the peak voltage over the MOSFET is computed analytically as follows:

Vsw,peak = 48 + 1.9 ∗ 15 = 76.5 V

This value is in parallel with the peak voltage value obtained from the simulations of the Flyback Converter circuit in Simulink.

The peak voltage value for the MOSFET is obtained as Vsw,peak = 76.63V from simulations.

The maximum current stress over the MOSFET is obtained analytically by the following relation.

Isw,peak =

1
(1 − D)

NS
NP

Io +

NP
NS

(1 − D)Ts
2Lm

Vo

where Io =

Po
Vo

=

60
15 = 4 A

Then, the peak MOSFET current is found as follows:

Isw,peak =

1
(1 − 0.26) ∗

1
1.9

∗ 4 + 1.9 ∗

(1 − 0.26) ∗ (1/45000)
2 ∗ 28.67 ∗ 10⁻⁶

∗ 15 = 11 A

One thing to notice here is that this peak current is computed assuming CCM operation. However, in our design, the converter mostly operates in DCM as seen from the voltage and current figures presented in the Simulation Results part. Therefore, for the MOSFET peak current value, we need to rely on the simulation results.

From the simulations of the Flyback Converter circuit in Simulink, the MOSFET peak current is observed as Isw,peak = 9.690 A

Overall, the peak voltage and current ratings for the MOSFET is found as follows:

Vsw,peak = 76.63 V

Isw,peak = 9.690 A

Isw,mean =

Iout
NP S

= 2.1A

The selected MOSFET should also be able to handle the switching frequencies as high as 45 kHz. Since it is a very commonly used value, choosing a 100v MOSFET is reasonable. AOD482 by Alpha-Omega is a good choice since it is rated at 5A continuous, has a low ON resistance and costs relatively low.

### 5.5 Diode Selection

Similar to the MOSFET selection, the maximum voltage and current stresses over the diode must be determined for the diode selection.

The maximum reverse voltage across the diode during its off period can be calculated as

VD = Vout + NP SVin,max = −40.26V

It is observed to be Vdiode,peak = −40.26 V from the simulations.

The maximum forward current through the diode during its on period can be calculated as:

Is,peak =

2Pout

DMAGVOUT

= 18.89A

It is observed to be Idiode,peak = Is,peak = 18.34 A from the simulations.

Overall, the peak voltage and current ratings for the diode is found as follows:

Vdiode,peak = −40.26 V

Idiode,peak = 18.34 A

Also, it should be noted that the average current of the diode will be equal to the output. Therefore SS5P5 from Vishay is chosen which is a Fast Recovery Schottky diode with 50V and 5A continuous rated diode which is right for the job.

### 5.6 Output Capacitor Selection

The average voltage across the output capacitor is equal to the average output voltage.

Vcap,avg = Vout = 15

Then, the rated voltage of the selected capacitor must be greater than 15 V.

Vcap,rated > 15 V

One another limitation on the capacitor selection is the peak-to-peak output voltage ripple limit of the project. The peak-to-peak output voltage ripple is required to be less than 4%.

∆Vo
Vo

= 0.04 (4%)

Then, the maximum allowable output voltage ripple is found as:

∆Vo = 0.04 ∗ 15 V = 0.6 V

Also, let’s calculate the maximum allowable ESR for the required ripple.

ESRCOUT =

0.9Vripple

Is,max

= 20mΩ

The output voltage ripple for the Flyback Converter topology is computed from the following relation.

∆Vo
Vo

=

DTs
RC =

D
RCfs

Then, the minimum required output capacitance value is obtained as follows:

Cmin =

D
0.04 ∗ R ∗ fs

where R =

V

2
o
Po

=

15²
60 =

225
60 = 3.75 Ω

Cmin =

0.26
0.04 ∗ 3.75 ∗ 45000

= 77.8 µF

Also, let’s calculate the maximum allowable ESR for the required ripple.

ESRCOUT =

0.9Vripple

Is,max

= 20mΩ

Since it is either hard to find or very costly, using ceramic capacitors can not be used. Instead, using electrolytic capacitors in series is a good idea. However, we need to use them in parallel to reduce the ripple. Moreover, since ESR generally increases with lower capacitance a good balance needs to be found.

Using two of ESY477M025AG6AA capacitors from KEMET is a good solution. Since they have an ESR of 0.41mΩ and 470µF capacitance, they satisfy the ripple requirement. From the simulations of the converter circuit in Simulink with the chosen output capacitor, the output voltage ripple is observed to be approximately 0.36 V, which is much lower than the maximum allowable output voltage ripple value of 0.6 V, as computed above.

The peak to peak current ripple on the output capacitor is also obtained from simulations of the converter circuit in Simulink with the chosen capacitors used. The peak to peak current ripple on the output capacitor is observed to be approximately 18.16 A.

## 6 Conclusion

In this report, our goal of designing a DC-DC converter as the Hardware Project of EE464 course is evaluated in detail. First, a topology for this task -Flyback Converter in our case- is chosen. Then, the main design choices and their theoretical background for Flyback Converter are discussed. After calculations, the findings are supported and verified with computer simulations. According to the obtained data, real components are chosen as a step to realize the circuit.

## 7 References

http://www.ti.com/lit/ds/symlink/ucc28740.pdfhttp://www.ti.com/lit/an/slua700/slua700.pdfhttps://www.fujielectric.com/products/semiconductor/model/power_supply/techn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
