orhuntas/EE464HW-SontAS/Final Report/parameters.xlsx

fs | 45000
Np | 28
turns ratio | 1.6
Ns | 18 |  |  |  | Cable Selection | Diameter | Cross Section
 |  |  |  |  | AWG#09 | 2.90576 | 6.63
 |  |  |  |  | AWG#10 | 2.58826 | 5.26
Skin Depth | 0.3535533906 |  |  |  | AWG#11 | 2.30378 | 4.17
 |  |  |  |  | AWG#12 | 2.05232 | 3.31
 |  |  |  |  | AWG#13 | 1.8288 | 2.63
 |  |  |  |  | AWG#14 | 1.62814 | 2.08
P Length | 1099.557429 |  |  |  | AWG#15 | 1.45034 | 1.65
S Length | 706.8583471 |  |  |  | AWG#16 | 1.29032 | 1.31
 |  |  |  |  | AWG#17 | 1.15062 | 1.04
P App | 1100 |  |  |  | AWG#18 | 1.02362 | 0.823
S App | 710 |  |  |  | AWG#19 | 0.91186 | 0.653
 |  |  |  |  | AWG#20 | 0.8128 | 0.519
R Pri (DC) | 0.0366212
R Sec (DC) | 0.02363732
R Pri (AC) | 0.03725109167 | Ohm | 37.25109167 | mOhm
R Sec (AC) | 0.02404388644 | Ohm | 24.04388644 | mOhm
 |  |  |  |  | Selected Core | E | F | MLT
 |  |  |  |  | 0P42513EC | 17.5 | 7.5 | 39.26990817
 |  |  |  |  | Selected Cable | Diameter | Cross Section | Effective Area | Ohms per km | Ohms per mm
 |  |  |  |  | AWG#20 | 0.8128 | 0.519 | 0.5100947313 | 33.292 | 3.3292e-05
