orhuntas/EE464HW-SontAS/Final Report/PCB/pcbcomplete/imgs/31h5t44lDqL.jpg

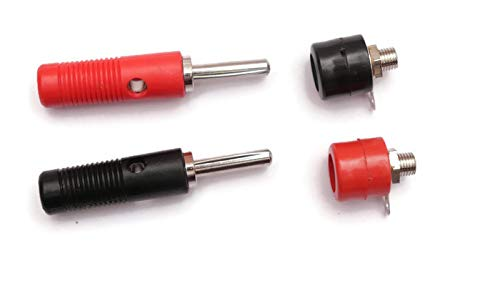
Final Report/PCB/pcbcomplete/imgs/31h5t44lDqL.jpg
