orhuntas/EE464HW-SontAS/Final Report/tex/bode_plots/bode2_G(s).png

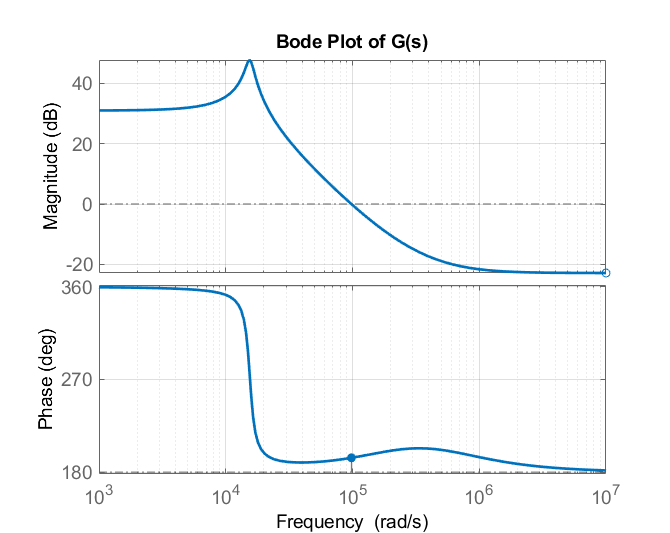
Final Report/tex/bode_plots/bode2_G(s).png
