orhuntas/EE464HW-SontAS/Final Report/tex/bode_plots/bode3.png

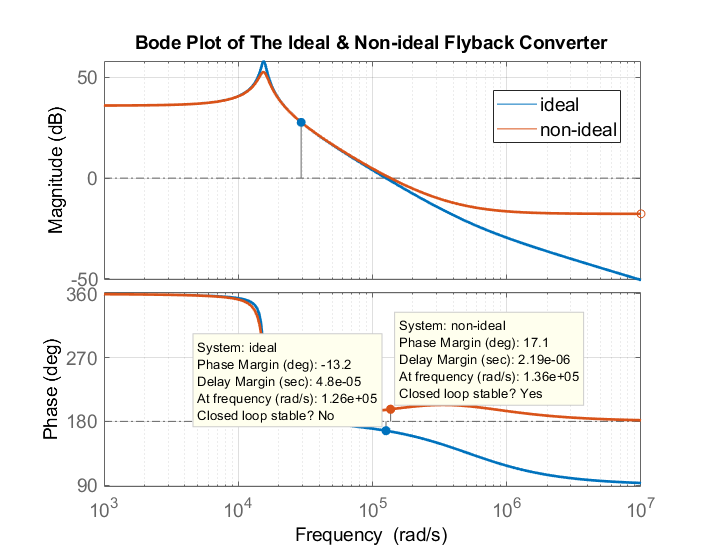
Final Report/tex/bode_plots/bode3.png
