orhuntas/EE464HW-SontAS/Final Report/tex/Compensator/flyback_tf3_2.png

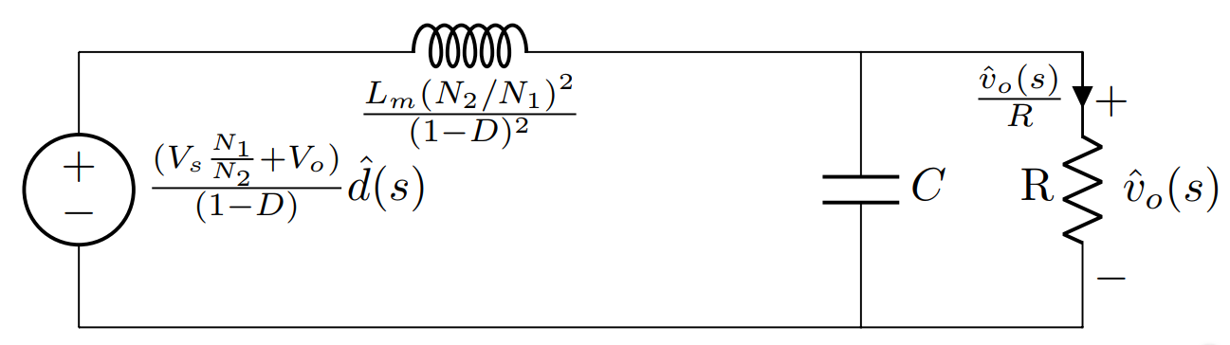
Final Report/tex/Compensator/flyback_tf3_2.png
