orhuntas/EE464HW-SontAS/Final Report/tex/figures/Analog_Controller.png

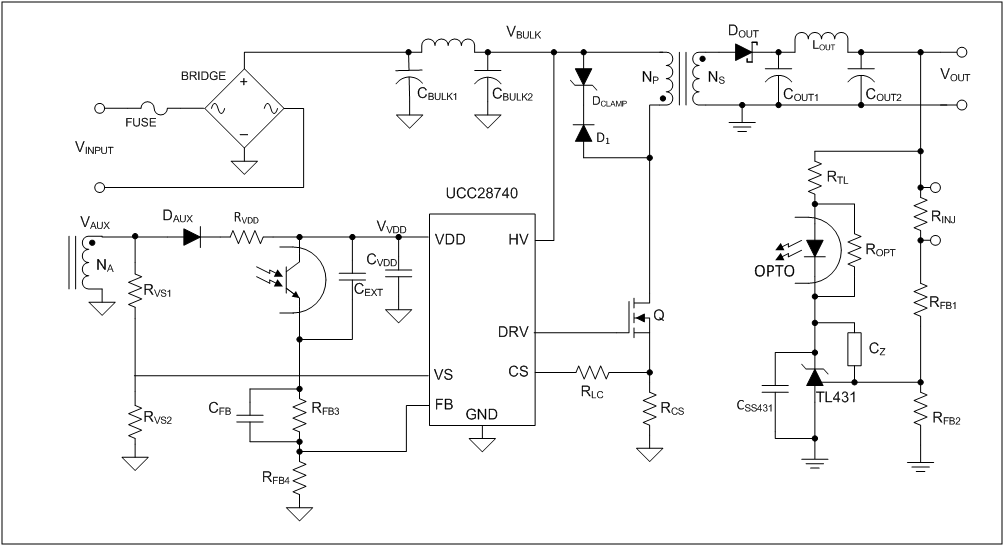
Final Report/tex/figures/Analog_Controller.png
