orhuntas/EE464HW-SontAS/Final Report/tex/figures/core.PNG

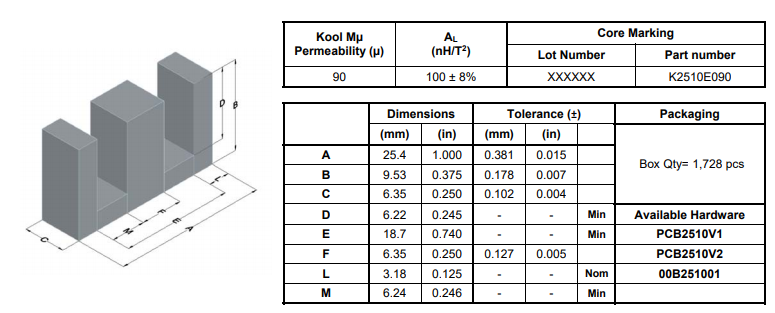
Final Report/tex/figures/core.PNG
