orhuntas/EE464HW-SontAS/Final Report/tex/figures/diode_thermal.PNG

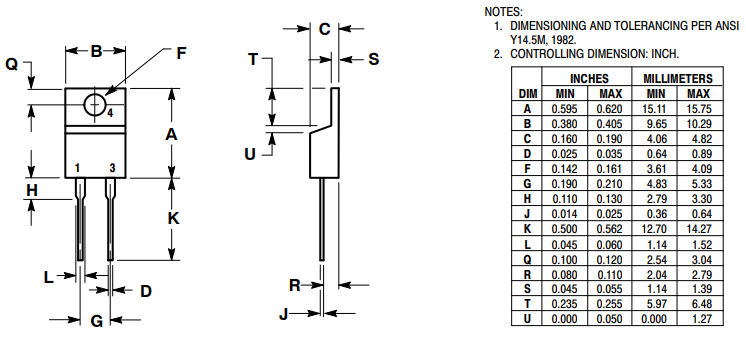
Final Report/tex/figures/diode_thermal.PNG
