orhuntas/EE464HW-SontAS/Final Report/tex/figures/mosfet_thermal.PNG

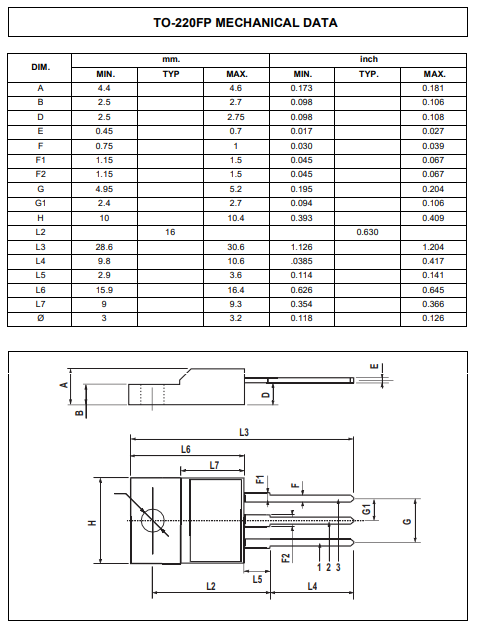
Final Report/tex/figures/mosfet_thermal.PNG
