orhuntas/EE464HW-SontAS/Final Report/PCB/pcbcomplete/flybackBOM.xlsx

Id | Designator | Supplier and ref | Quantity | Unit Price | Total Price
1 | C1,CFB1,Cz1,Cvdd1,Css431,Ccs1,Cext1 | TDK C1608C0G1V103J080AC | 6 | 0.04 | 0.24
2 | Transistor Heatsink | Assmann WSW Components, V5220L | 1 | 0.8 | 0.8
3 | Diode Heatsink | CUI Devices, HSS-B20-NP-01 | 1 | 0.2 | 0.2
4 | D5 | ON Semi, MBR10100G | 1 | 0.85 | 0.85
5 | RVS1,RLC1,RFB3,RFB4,RCS1 | Yageo, RC0402FR | 5 | 0.001 | 0.005
6 | TL431LP | Texas Instruments | 1 | 0.124 | 0.124
7 | Cout1 | Panasonic,EEE1HA211P | 1 | 0.62 | 0.62
8 | Dclamp1 | Vishay, MSP3V3 | 1 | 0.08 | 0.08
9 | D1 | ON Semi, BAT54HT1G | 1 | 0.041 | 0.041
10 | J1,J2 (Banana_Jack_2Pin) | Cinch Connectivity | 4 | 0.6 | 2.4
11 | Rvdd1,RTL1,Ropt1,RFB2,RFB1,RVS2 | Yageo, RC0603JR | 6 | 0.002 | 0.012
12 | D3 | Vishay, B120-E3 | 1 | 0.08 | 0.08
13 | U2 | Texas Instruments, UCC28740DR | 1 | 0.46 | 0.46
14 | Transformer Core | Magnetics, 00K2510E090 | 1 | 4.17 | 4.17
15 | Transformer Bobbin | Ferroxcube, CSH-EP13-1S-10P-T | 1 | 0.25 | 0.25
16 | U1 | Isocom, SFH617A-2X | 1 | 0.59 | 0.59
17 | M1 | STMicroelectronics, STP17NK40ZFP | 1 | 3.3 | 3.3
18 | PCB | PCBWay | 1 | 1.38 | 1.38
 |  |  |  |  | 15.602
