orhuntas/EE464HW-SontAS/Final Report/LTSpice/flyback_compensated.asc

Cc1: cap; 130n
Cc2: cap; 7n
Cf3: cap; 10n
Cout: cap; 470µ
D1: schottky; MBR20100CT
L1: ind2; 36.1µ
L2: ind2; 10µ
M1: nmos; BSC320N20NS3
M2: nmos; BSC320N20NS3
Rc1: res; 1k
Rc: res; 20m
Rf1: res; 8.8k
Rf2: res; 765
Rf3: res; 940
Rload1: res; 7.5
RLoad2: res; 7.5
U1: UniversalOpamp2
U2: UniversalOpamp2
V1: voltage; 5
V2: voltage; 1.2
V3: voltage; PULSE(0 1.8 0 0.00002221 0 0 0.00002222)
V4: voltage; PULSE(5 0 5m 1p 1p 5m 10m 1)
Vin: voltage; 48
Named nets: 0, Vin, Vout, Vref, +, Vosc, pulse, V_ERROR
K L1 L2 1
.tran 0 0.01 0
