orhuntas/EE464HW-SontAS/Final Report/PCB/pcbcomplete/flyback.kicad_pcb

## KiCad design Final Report/PCB/pcbcomplete/flyback.kicad_pcb (2020-06-24)

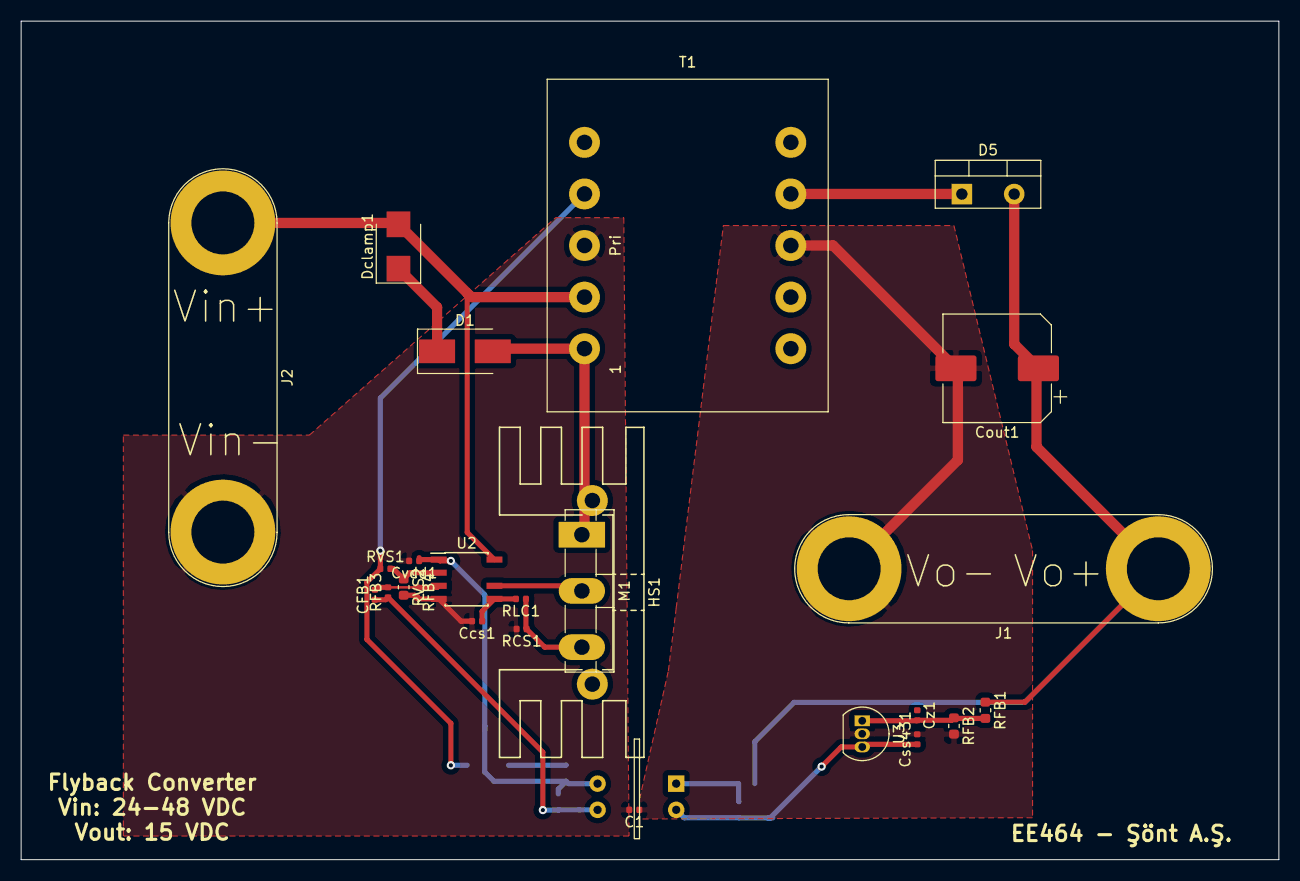
[picture p126: board flyback.kicad_pcb from above]

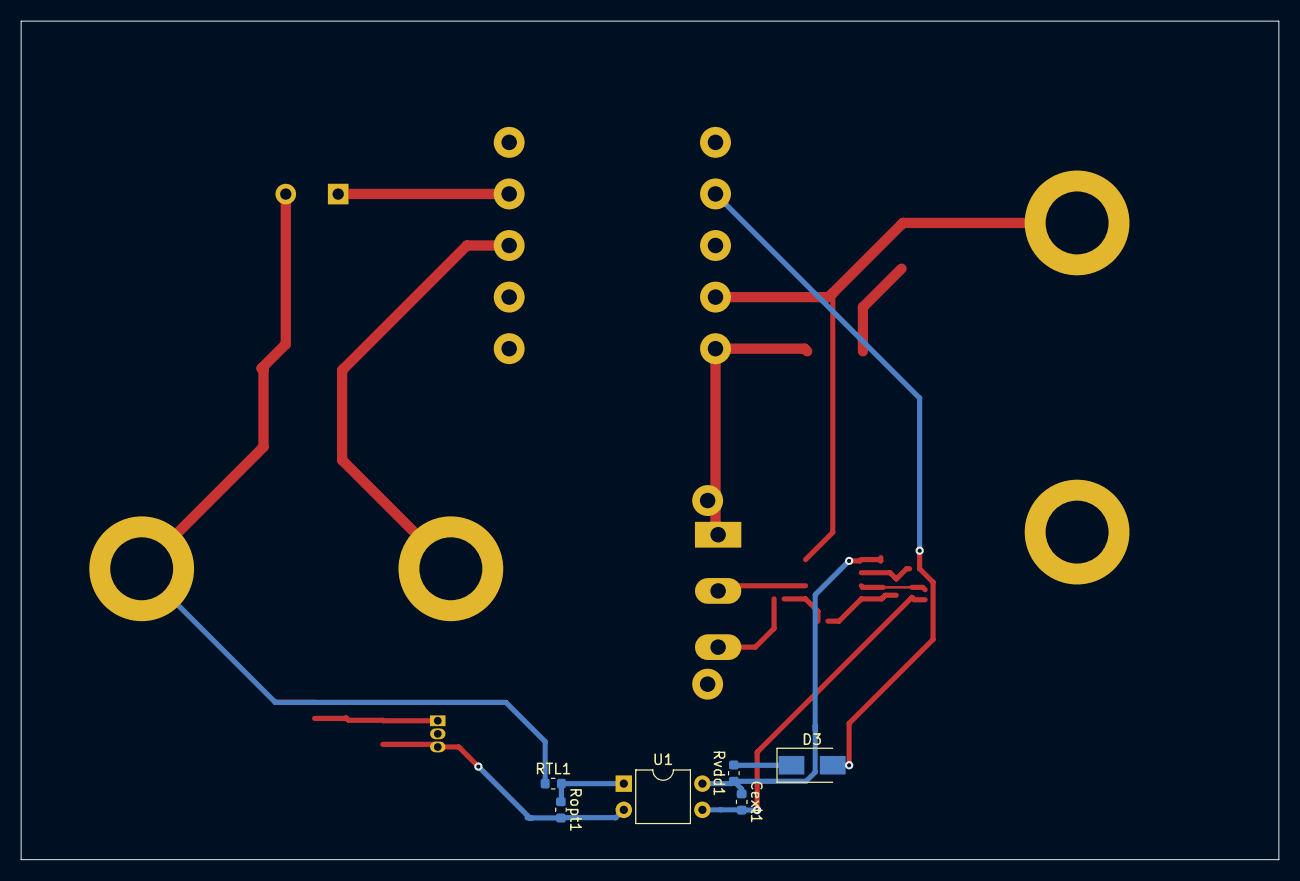
[picture p127: board flyback.kicad_pcb from below]

Board: 2 copper layers, 121.9 x 81.3 mm, 31 parts (6 on the bottom side), 19 nets.

Parts:
C1: C; C_0402_1005Metric
CFB1: C; C_0402_1005Metric
Ccs1: C; C_0402_1005Metric
Cext1: C; C_0603_1608Metric
Cout1: CP1; CP_Elec_10x10
Css431: C; C_0402_1005Metric
Cvdd1: C; C_0402_1005Metric
Cz1: C; C_0402_1005Metric
D1: D; D_SMB_Handsoldering
D3: B120-E3; D_SMA
D5: D_Schottky; TO-220-2_Vertical
Dclamp1: D_Zener; D_SMB
HS1: Heatsink; Heatsink_Stonecold_HS-132_32x14mm_2xFixation1.5mm
J1, J2: Conn_01x02; Banana_Jack_2Pin
M1: MNMOS; TO-3P-3_Vertical
RCS1: R; R_0402_1005Metric
RFB1, RFB2: R; R_0603_1608Metric
RFB3, RFB4: R; R_0402_1005Metric
RLC1: R; R_0402_1005Metric
RTL1: R; R_0603_1608Metric
RVS1: R; R_0402_1005Metric
RVS2: R; R_0603_1608Metric
Ropt1: R; R_0603_1608Metric
Rvdd1: R; R_0603_1608Metric
T1: Transformer_1P_2S; Transformer_CHK_EI30-2VA_2xSec
U1: SFH617A-1; DIP-4_W7.62mm
U2: UCC28740; SOIC-8-N7_3.9x4.9mm_P1.27mm
U3: TL431LP; TO-92_Inline

Connections:
+48V: Dclamp1.2, J2.1, T1.1, U2.8
/OPTO+: RTL1.2, Ropt1.1, U1.1
/OPTO-: Css431.1, Cz1.1, Ropt1.2, U1.2, U3.3
/Vout+: Cout1.1, D5.2, J1.1, RFB1.1, RTL1.1
GND: C1.2, Ccs1.2, Cvdd1.2, J2.2, RCS1.2, RFB4.2, RVS2.2, T1.6, U2.4
GND2: C1.1, Cout1.2, Css431.2, J1.2, RFB2.2, T1.4, U3.2
unnamed: CFB1.1, Cext1.2, RFB3.1, U1.3
unnamed: CFB1.2, RFB3.2, RFB4.1, U2.3
unnamed: Ccs1.1, RLC1.2, U2.5
unnamed: Cext1.1, Cvdd1.1, Rvdd1.1, U1.4, U2.1
unnamed: Cz1.2, RFB1.2, RFB2.1, U3.1
unnamed: D1.1, Dclamp1.1
unnamed: D1.2, M1.1, T1.2
unnamed: D3.1, Rvdd1.2
unnamed: D3.2, RVS1.1, T1.5
unnamed: D5.1, T1.3
unnamed: M1.2, U2.6
unnamed: M1.3, RCS1.1, RLC1.1
unnamed: RVS1.2, RVS2.1, U2.2
