orhuntas/EE464HW-SontAS/(commit log)

2020-03-06 started on the project
    discussion about ICs are dıne,
    component calculations are made,
    research on magnetic design,
    created simulation model for inspection
2020-03-06 Magnetic Design Application Note
2020-03-12 Calculation Table is created
    Calculation Table is created and uploaded.
    [calculations_table.xlsx]
2020-03-23 simulation report
    done collectively on overleaf, hence no additional commmits
    [designgoals.xlsx]
2020-06-02 KiCad model of the converter for PCB design is created
    The flyback converter is modeled in KiCad for the PCB design. The circuit model of the flyback converter model with the selected controller IC is drawn in KiCad and footprint assignment for the used components is done.
    [flyback.kicad_pcb, flyback.sch, flyback_BOM.csv]
2020-06-02 The designed compensator is simulated in LTSpice
    The designed type 3 A compensator is drawn and simulated in LTSpice for different step changes in the load and also in the input voltage.
    Two LTSpice models are created to simulate the step change in the load from half to full load, and to simulate the step change in the input voltage from 48V to 24V.
2020-06-02 Create parameters.xlsx
    An excel sheet is created to make the calculations of the copper length and resistances of the primary and the secondary windings of the transformer iterable with different core and cable selections.
    [parameters.xlsx]
2020-06-23 pcb design
    pcb design complete including layout and 3D view. BOM should be edited.
    [flyback-B_Cu.gbr, flyback-B_Mask.gbr, flyback-B_Paste.gbr, flyback-B_SilkS.gbr, flyback-Edge_Cuts.gbr, flyback-F_Cu.gbr, flyback-F_Mask.gbr, flyback-F_Paste.gbr]
2020-06-24 final additions
    pcb design revisited, gerber files, 3D views generated, images are added, final additions to the report
    [flyback.csv, flyback.kicad_pcb, flyback.sch, flybackBOM.xlsx, flyback_BOM.csv]
